xKMx1/linefollowerk/3D models/TB6612FNG.step

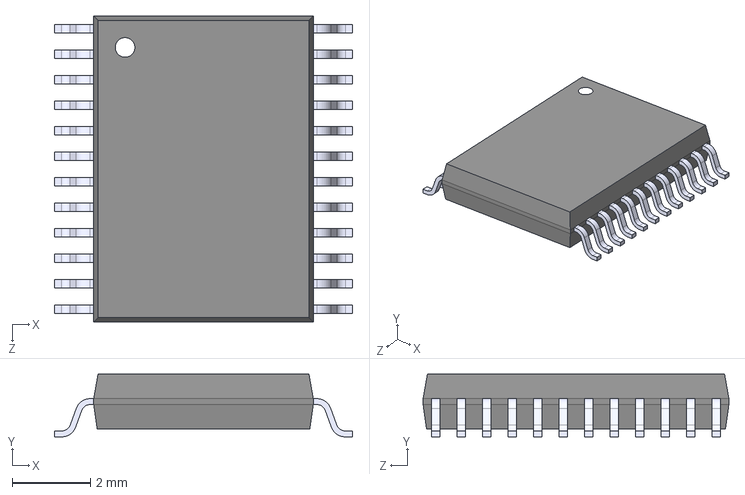
[picture p1: CAD file, 2026-10-03]
3D models/TB6612FNG.step
7.60 x 1.60 x 7.80 mm
