xKMx1/linefollowerk/3D models/TPS563201DDCR.step

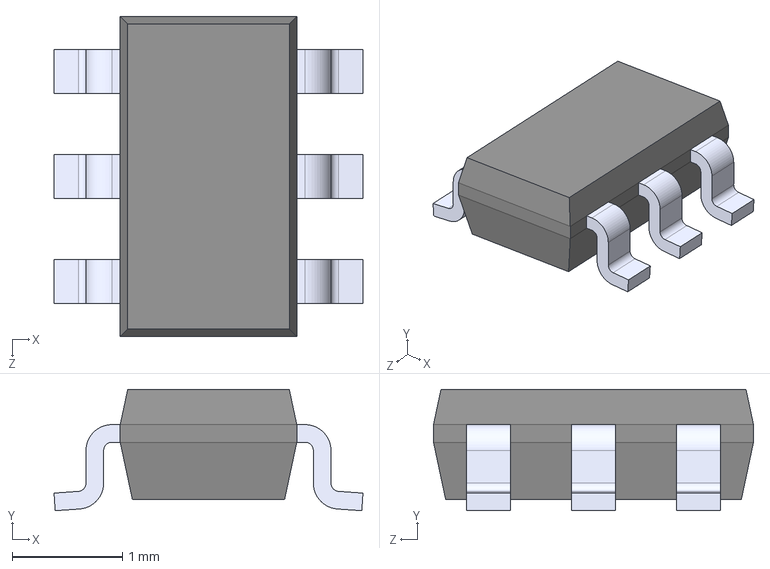
[picture p2: CAD file, 2026-10-03]
3D models/TPS563201DDCR.step
2.80 x 1.10 x 2.90 mm
