xKMx1/linefollowerk/archive/ZC142200.step

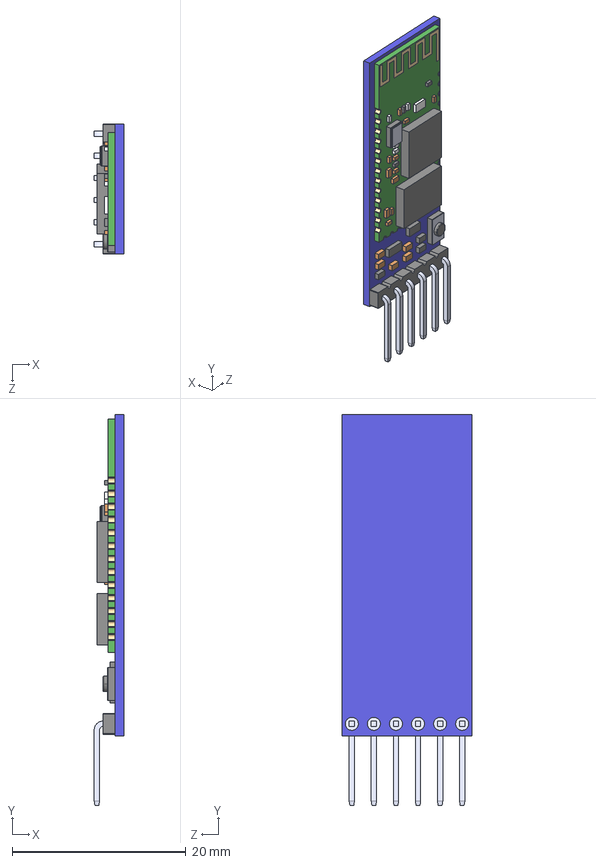
[picture p3: CAD file, 2026-10-03, an earlier design]
archive/ZC142200.step
3.41 x 45.0 x 15.0 mm
ZC142200
HC-05
