xKMx1/linefollowerk/linefollowerk.kicad_pcb

## KiCad design linefollowerk.kicad_pcb (2026-10-03)

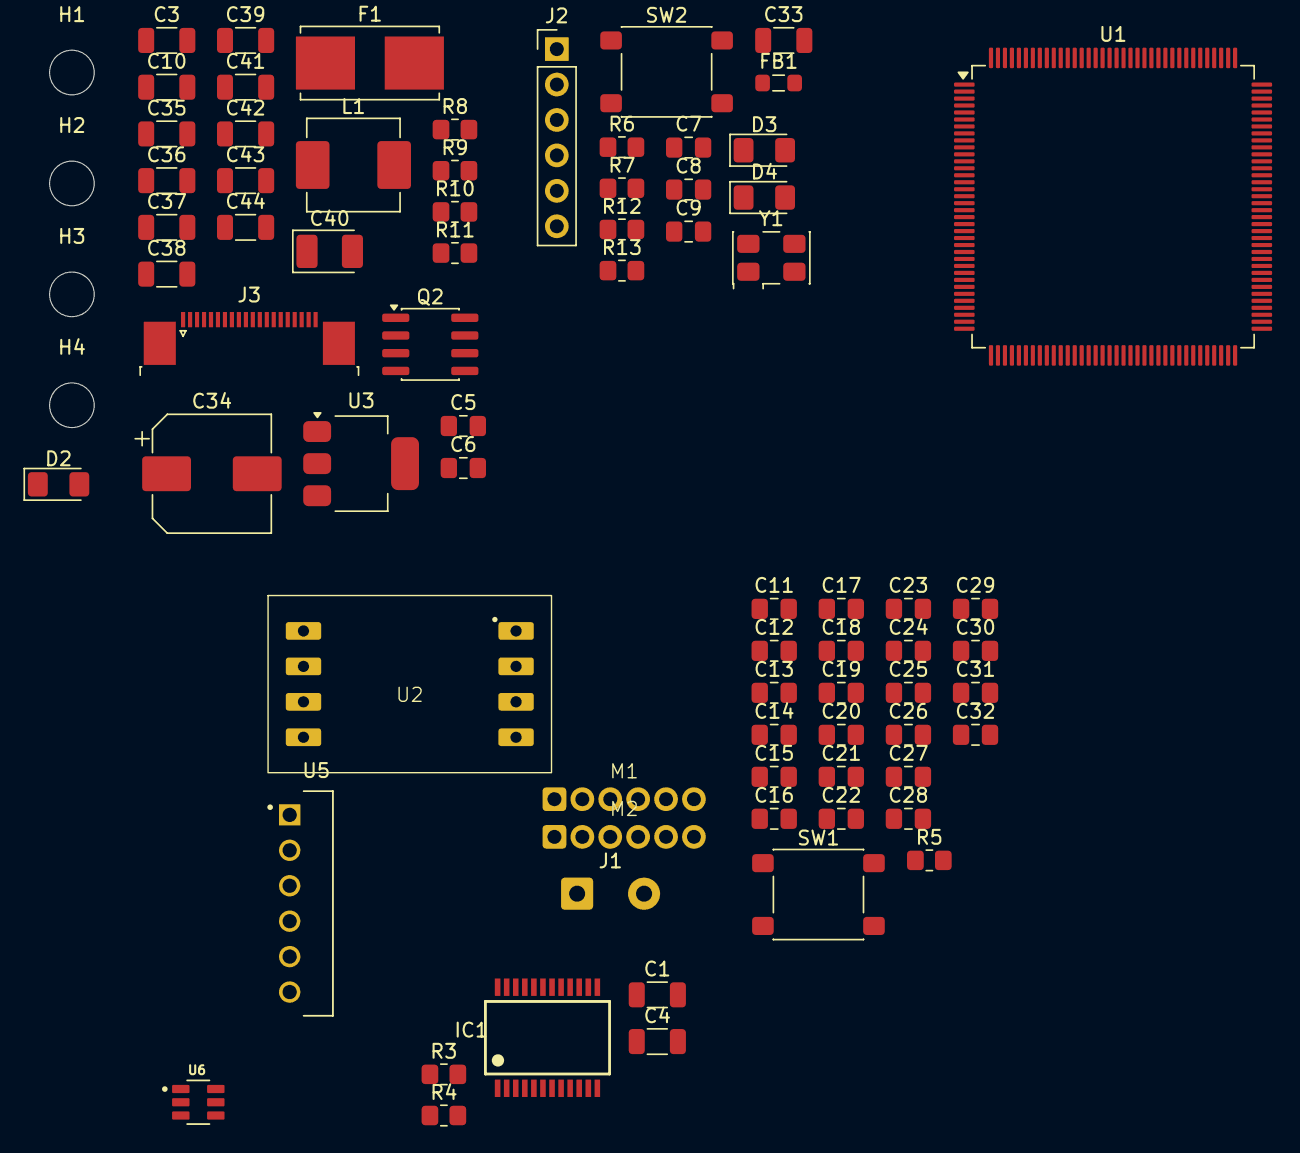
[picture p4: board linefollowerk.kicad_pcb from above]

Board: 2 copper layers, 79 parts (0 on the bottom side), 57 nets, no tracks yet.

Parts:
C1, C4, C33, C37, C44: 100nF; C_1206_3216Metric
C3, C10, C35, C36, C39, C42, C43: 10uF; C_1206_3216Metric
C5, C23: 10uF; C_0805_2012Metric_Pad1.18x1.45mm_HandSolder
C6, C9, C11, C12, C13, C14, C15, C16, C17, C18, C19, C20, C21, C22, C24, C25, C29, C30: 100nF; C_0805_2012Metric_Pad1.18x1.45mm_HandSolder
C7, C8: 10pF; C_0805_2012Metric_Pad1.18x1.45mm_HandSolder
C26, C28: 1uF; C_0805_2012Metric_Pad1.18x1.45mm_HandSolder
C27: 10nF; C_0805_2012Metric_Pad1.18x1.45mm_HandSolder
C31, C32: 2.2uF; C_0805_2012Metric_Pad1.18x1.45mm_HandSolder
C34: 470uF; CP_Elec_8x10
C38, C41: 22uF; C_1206_3216Metric
C40: 22uF; CP_EIA-3528-21_Kemet-B_HandSolder
D2, D4: RED; LED_1206_3216Metric_Pad1.42x1.75mm_HandSolder
D3: GREEN; LED_1206_3216Metric_Pad1.42x1.75mm_HandSolder
F1: Fuse; Fuseholder_Littelfuse_Nano2_154x
FB1: 220Ω@100MHz; L_0805_2012Metric_Pad1.05x1.20mm_HandSolder
H1, H2, H3, H4: MountingHole; MountingHole_3.2mm_M3
IC1: TB6612FNG; SSOP24
J1: Conn_01x02_Pin; SolderWire-0.5sqmm_1x02_P4.8mm_D0.9mm_OD2.3mm
J2: SWD Connector; PinHeader_1x06_P2.54mm_Vertical
J3: FFC 20p; TE_2-1734839-0_1x20-1MP_P0.5mm_Horizontal
L1: 3.3uH; L_Vishay_IHLP-2525
M1, M2: POLOLU_ENCODER_FOOTPRINT
Q2: AO4407A; SOIC-8_3.9x4.9mm_P1.27mm
R3, R5, R9, R11: 10k; R_0805_2012Metric_Pad1.20x1.40mm_HandSolder
R4, R12, R13: 1k; R_0805_2012Metric_Pad1.20x1.40mm_HandSolder
R6, R10: 100k; R_0805_2012Metric_Pad1.20x1.40mm_HandSolder
R7: 47k; R_0805_2012Metric_Pad1.20x1.40mm_HandSolder
R8: 54.9k; R_0805_2012Metric_Pad1.20x1.40mm_HandSolder
SW1: PTS645; SW_SPST_PTS645Sx43SMTR92
SW2: SW_Push; SW_SPST_PTS645Sx43SMTR92
U1: STM32H743ZIT6; LQFP-144_20x20mm_P0.5mm
U2: MPU_6050
U3: AMS1117-3.3; SOT-223-3_TabPin2
U5: HC-06; MODULE_ZC142200
U6: TPS563201DDCR; SOT95P280X110-6N
Y1: Crystal_GND24; Crystal_SMD_5032-4Pin_5.0x3.2mm

Connections:
+3V3: C3.1, C4.1, C5.1, C6.1, C11.2, C12.2, C13.2, C14.2, C15.2, C16.2, C17.2, C18.2, C19.2, C20.2, C21.2, C22.2, C23.2, C24.2, C25.2, C28.2, C40.1, FB1.2, IC1.20 (VCC), J2.1, J3.1, M1.4 (VCC), M2.4 (VCC), R4.1, U1.6 (VBAT), U1.17 (VDD), U1.30 (VDD), U1.39 (VDD), U1.52 (VDD), U1.62 (VDD), U1.72 (VDD), U1.84 (VDD), U1.95 (VDD33_USB), U1.108 (VDD), U1.121 (VDD), U1.131 (VDD), U1.143 (PDR_ON), U1.144 (VDD), U3.2 (VO)
+3V3A: C26.2, C27.2, C30.1, FB1.1, U1.32 (VREF+), U1.33 (VDDA)
+5V: C38.2, C39.1, C41.2, L1.1, R8.1, U2.1 (VCC), U2.5 (VCC), U3.3 (VI), U5.5 (VCC)
/BOOT0: R5.1, U1.138 (BOOT0)
/NRST: C29.2, J2.5, U1.25 (NRST)
/OSC_IN: C7.2, U1.23 (PH0), Y1.1
/OSC_OUT: C8.1, U1.24 (PH1), Y1.3
/PA4: C33.1, R6.1, R7.2, U1.40 (PA4)
/Peripherials/LED_IN: D2.2 (A), R4.2
/Peripherials/MA_OUT1: IC1.1 (AO1), IC1.2 (AO1'), M1.6 (M1)
/Peripherials/MA_OUT2: IC1.5 (AO2), IC1.6 (AO2'), M1.5 (M2)
/Peripherials/MB_OUT1: IC1.11 (BO1), IC1.12 (BO1'), M2.6 (M1)
/Peripherials/MB_OUT2: IC1.7 (BO2), IC1.8 (BO2'), M2.5 (M2)
/Peripherials/PMOS_G: Q2.4 (G), R3.1
/START_SW: C9.1, SW2.1, U1.7 (PC13)
/SWCLK: J2.2, U1.109 (PA14)
/SWDIO: J2.4, U1.105 (PA13)
/SWO: J2.6, U1.133 (PB3)
A_IN1: IC1.21 (AIN1), U1.87 (PG2)
A_IN2: IC1.22 (AIN2), U1.88 (PG3)
A_PWM: IC1.23 (PWMA), U1.81 (PD12)
B_IN1: IC1.17 (BIN1), U1.89 (PG4)
B_IN2: IC1.16 (BIN2), U1.90 (PG5)
B_PWM: IC1.15 (PWMB), U1.82 (PD13)
GND: C1.2, C3.2, C4.2, C5.2, C6.2, C7.1, C8.2, C9.2, C10.2, C11.1, C12.1, C13.1, C14.1, C15.1, C16.1, C17.1, C18.1, C19.1, C20.1, C21.1, C22.1, C23.1, C24.1, C25.1, C26.1, C27.1, C28.1, C29.1, C30.2, C31.2, C32.1, C33.2, C34.2, C35.2, C36.2, C38.1, C39.2, C40.2, C41.1, C42.1, C43.1, C44.1, D2.1 (K), D3.1 (K), D4.1 (K), IC1.3 (PGND1), IC1.4 (PGND1'), IC1.9 (PGND2), IC1.10 (PGND2'), IC1.18 (GND), J1.1, J2.3, J3.20, M1.1 (GND), M2.1 (GND), R3.2, R5.2, R7.1, R9.1, R11.2, SW1.1, SW1.2, SW2.2, U1.16 (VSS), U1.31 (VSSA), U1.38 (VSS), U1.51 (VSS), U1.61 (VSS), U1.83 (VSS), U1.94 (VSS), U1.107 (VSS), U1.120 (VSS), U1.130 (VSS), U2.4 (GND), U2.8 (GND), U3.1 (GND), U5.4 (GND), U6.1 (GND), Y1.2 (G), Y1.4 (G)
HC_06_RX: U1.75 (PB14), U5.2 (RX)
HC_06_TX: U1.76 (PB15), U5.3 (TX)
L_E_OUT_A: M1.3 (OUT_A), U1.34 (PA0)
L_E_OUT_B: M1.2 (OUT_B), U1.35 (PA1)
MPU_RX: U1.119 (PD5), U2.2 (RX)
MPU_SCL: U1.136 (PB6), U2.6 (SCL)
MPU_SDA: U1.137 (PB7), U2.7 (SDA)
MPU_TX: U1.122 (PD6), U2.3 (TX)
M_STBY: IC1.19 (STBY), R11.1, U1.91 (PG6)
unnamed: C31.1, U1.106 (VCAP)
unnamed: C32.2, U1.71 (VCAP)
unnamed: D3.2 (A), R12.1
unnamed: D4.2 (A), R13.2
unnamed: F1.2, J1.2
unnamed: R12.2, U1.141 (PE0)
unnamed: R13.1, U1.142 (PE1)
unnamed: R10.2, U6.5 (EN)
unnamed: C37.2, L1.2, U6.2 (SW)
unnamed: C37.1, U6.6 (VBST)
unnamed: R8.2, R9.2, U6.4 (VFB)
R_E_OUT_A: M2.3 (OUT_A), U1.42 (PA6)
R_E_OUT_B: M2.2 (OUT_B), U1.43 (PA7)
SENS1: J3.9, U1.13 (PF3)
SENS2: J3.10, U1.14 (PF4)
SENS3: J3.11, U1.15 (PF5)
SENS4: J3.12, U1.18 (PF6)
SENS5: J3.8, U1.19 (PF7)
SENS6: J3.5, U1.20 (PF8)
SENS7: J3.6, U1.21 (PF9)
SENS8: J3.7, U1.22 (PF10)
VBAT: F1.1, Q2.5 (D), Q2.6 (D), Q2.7 (D), Q2.8 (D)
VIN: C1.1, C10.1, C34.1, C35.1, C36.1, C42.2, C43.2, C44.2, IC1.13 (VM2), IC1.14 (VM3), IC1.24 (VM1), Q2.1 (S), Q2.2 (S), Q2.3 (S), R6.2, R10.1, U6.3 (VIN)
