xKMx1/linefollowerk/code/linefollower.ioc

Mcu.UserName=STM32H743ZITx
PA0.Signal=S_TIM2_CH1_ETR
PA1.Signal=S_TIM2_CH2
PA4.Signal=ADCx_INP18
PA6.Signal=S_TIM3_CH1
PA7.Signal=S_TIM3_CH2
PB14.Signal=USART1_TX
PB15.Signal=USART1_RX
PB6.Signal=I2C1_SCL
PB7.Signal=I2C1_SDA
PC13.GPIO_Label=BTN_START
PC13.Signal=GPXTI13
PD12.Signal=S_TIM4_CH1
PD13.Signal=S_TIM4_CH2
PE0.GPIO_Label=LED1
PE0.Signal=GPIO_Output
PE1.GPIO_Label=LED2
PE1.Signal=GPIO_Output
PF10.Signal=ADC3_INP6
PF3.Signal=ADC3_INP5
PF4.Signal=ADC3_INP9
PF5.Signal=ADC3_INP4
PF6.Signal=ADC3_INP8
PF7.Signal=ADC3_INP3
PF8.Signal=ADC3_INP7
PF9.Signal=ADC3_INP2
PG2.GPIO_Label=AIN1
PG2.Signal=GPIO_Output
PG3.GPIO_Label=AIN2
PG3.Signal=GPIO_Output
PG4.GPIO_Label=BIN1
PG4.Signal=GPIO_Output
PG5.GPIO_Label=BIN2
PG5.Signal=GPIO_Output
PG6.GPIO_Label=M_STBY
PG6.Signal=GPIO_Output
