xKMx1/linefollowerk/code/Core/Inc/main.h

#define BTN_START_Pin GPIO_PIN_13
#define BTN_START_GPIO_Port GPIOC
#define BTN_START_EXTI_IRQn EXTI15_10_IRQn
#define AIN1_Pin GPIO_PIN_2
#define AIN1_GPIO_Port GPIOG
#define AIN2_Pin GPIO_PIN_3
#define AIN2_GPIO_Port GPIOG
#define BIN1_Pin GPIO_PIN_4
#define BIN1_GPIO_Port GPIOG
#define BIN2_Pin GPIO_PIN_5
#define BIN2_GPIO_Port GPIOG
#define M_STBY_Pin GPIO_PIN_6
#define M_STBY_GPIO_Port GPIOG
#define LED1_Pin GPIO_PIN_0
#define LED1_GPIO_Port GPIOE
#define LED2_Pin GPIO_PIN_1
#define LED2_GPIO_Port GPIOE
